igoraven/arduino-biologger/biologger/real-device.jpg

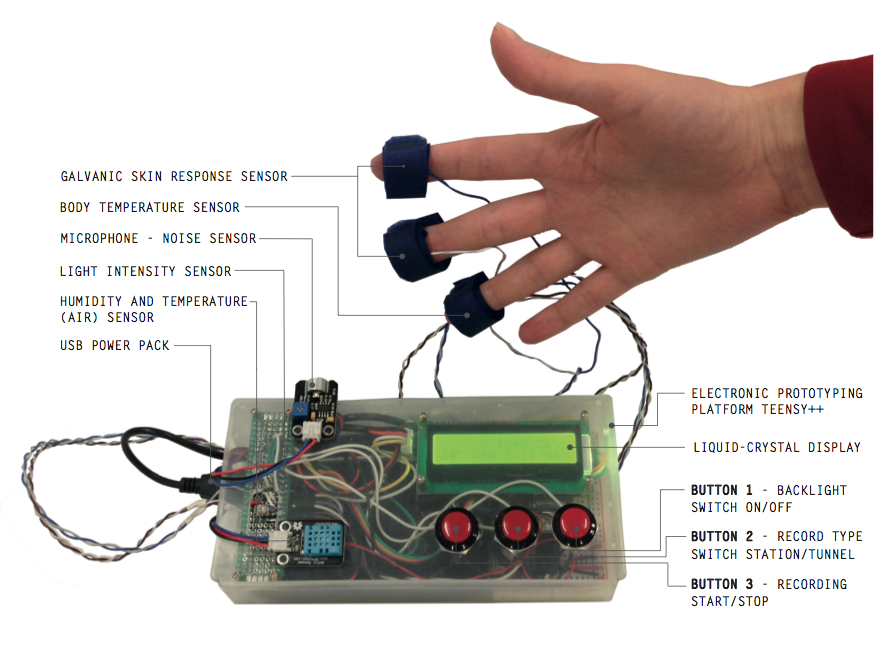
biologger/real-device.jpg
