igoraven/arduino-biologger/biologger/biologger-fz.png

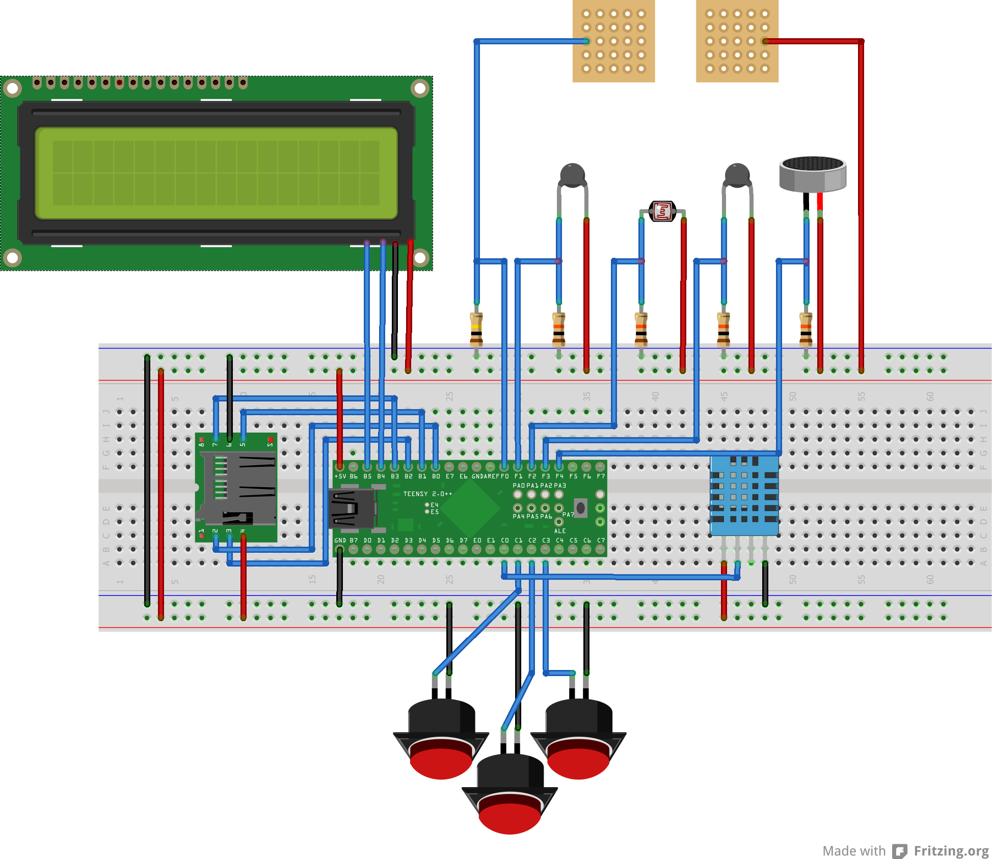
biologger/biologger-fz.png
